46nori/KiCad-Simulation/README.md

# KiCad-Simulation

KiCadでの回路作成時のシミュレーション置き場です。

|KiCad Project|内容 |
|---|---|
|[AudioMixier](./AudioMixer/README.md)|YM2608に接続するオーディオ回路|
