46nori/KiCad-Simulation/AudioMixer/AudioMixer.kicad_sch

## KiCad design AudioMixer/AudioMixer.kicad_sch (2025-07-20)

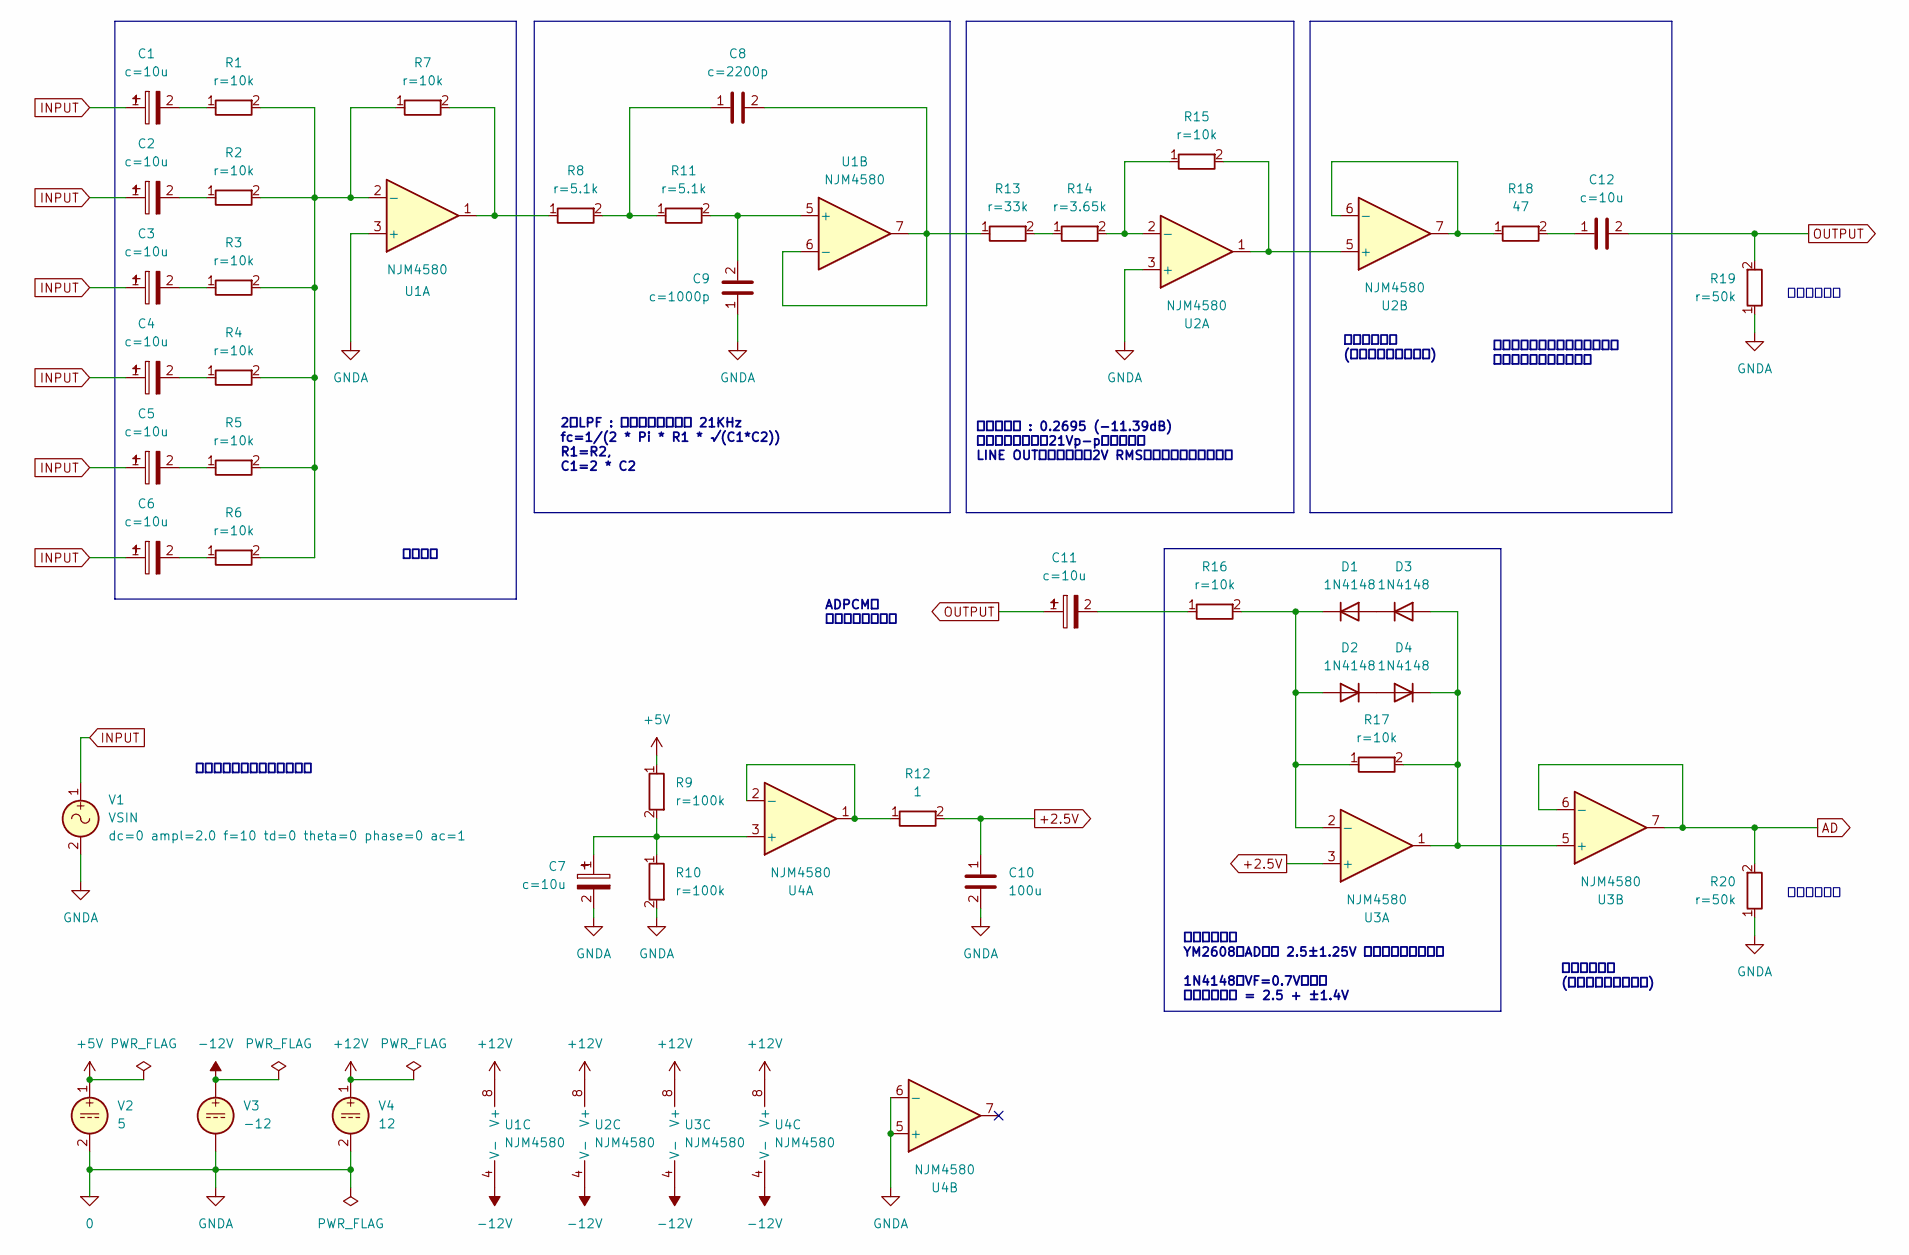
[picture p1: schematic AudioMixer.kicad_sch]

Parts:
C1, C2, C3, C4, C5, C6, C7, C11, C12: c=10u
C8: c=2200p
C9: c=1000p
C10: 100u
D1, D2, D3, D4: 1N4148; D_DO-35_SOD27_P7.62mm_Horizontal
R1, R2, R3, R4, R5, R6, R7, R15, R16, R17: r=10k
R8, R11: r=5.1k
R9, R10: r=100k
R12: 1
R13: r=33k
R14: r=3.65k
R18: 47
R19, R20: r=50k
U1, U2, U3, U4: NJM4580
V1: VSIN
V2: 5
V3: -12
V4: 12

Connections:
0: C7.2, C9.1, C10.2, R10.2, R19.1, R20.1, U1.3 (+), U2.3 (+), U4.5 (+), U4.6 (-), V1.2, V2.2, V3.2, V4.2
+2.5V: C10.1, R12.2, U3.3 (+)
+5V: R9.1, V2.1
+12V: U1.8 (V+), U2.8 (V+), U3.8 (V+), U4.8 (V+), V4.1
-12V: U1.4 (V-), U2.4 (V-), U3.4 (V-), U4.4 (V-), V3.1
AD: R20.2, U3.6 (-), U3.7
INPUT: C1.1, C2.1, C3.1, C4.1, C5.1, C6.1, V1.1
unnamed: C1.2, R1.1
unnamed: C2.2, R2.1
unnamed: C3.2, R3.1
unnamed: C4.2, R4.1
unnamed: C5.2, R5.1
unnamed: C6.2, R6.1
unnamed: C7.1, R9.2, R10.1, U4.3 (+)
unnamed: C8.1, R8.2, R11.1
unnamed: C8.2, R13.1, U1.6 (-), U1.7
unnamed: C9.2, R11.2, U1.5 (+)
unnamed: C11.2, R16.1
unnamed: C12.1, R18.2
unnamed: D1.1 (K), D2.2 (A), R16.2, R17.1, U3.2 (-)
unnamed: D1.2 (A), D3.1 (K)
unnamed: D2.1 (K), D4.2 (A)
unnamed: D3.2 (A), D4.1 (K), R17.2, U3.1, U3.5 (+)
unnamed: R1.2, R2.2, R3.2, R4.2, R5.2, R6.2, R7.1, U1.2 (-)
unnamed: R7.2, R8.1, U1.1
unnamed: R12.1, U4.1, U4.2 (-)
unnamed: R13.2, R14.1
unnamed: R14.2, R15.1, U2.2 (-)
unnamed: R15.2, U2.1, U2.5 (+)
unnamed: R18.1, U2.6 (-), U2.7
OUTPUT: C11.1, C12.2, R19.2

Notes on the sheet:
出力バッファ (ボルテージフォロア)
減衰アンプ : 0.2695 (-11.39dB) 前段の最大出力を21Vp-pとしたとき LINE OUTの標準である2V RMSに収まるようにする。
2次LPF : カットオフ周波数 21KHz fc=1/(2 * Pi * R1 * √(C1*C2)) R1=R2, C1=2 * C2
ADPCM用 サンプリング入力
インピーダンス調整・保護抵抗 カップリングコンデンサ
クリップ回路 YM2608のAD入力 2.5±1.25V に収まるようにする 1N4148のVF=0.7Vのとき クリップ範囲 = 2.5 + ±1.4V
テスト用負荷
テスト用オーディオ入力信号
加算回路
