46nori/KiCad-Simulation/(commit log)

2025-07-20 Change 1N4148 spice model
    [AudioMixer.kicad_sch]
2025-07-20 Update comment
    [AudioMixer.kicad_sch]
